AIoT-Consulting/atr-public/3d/ATR-USB-3D Case Cover Label.pdf

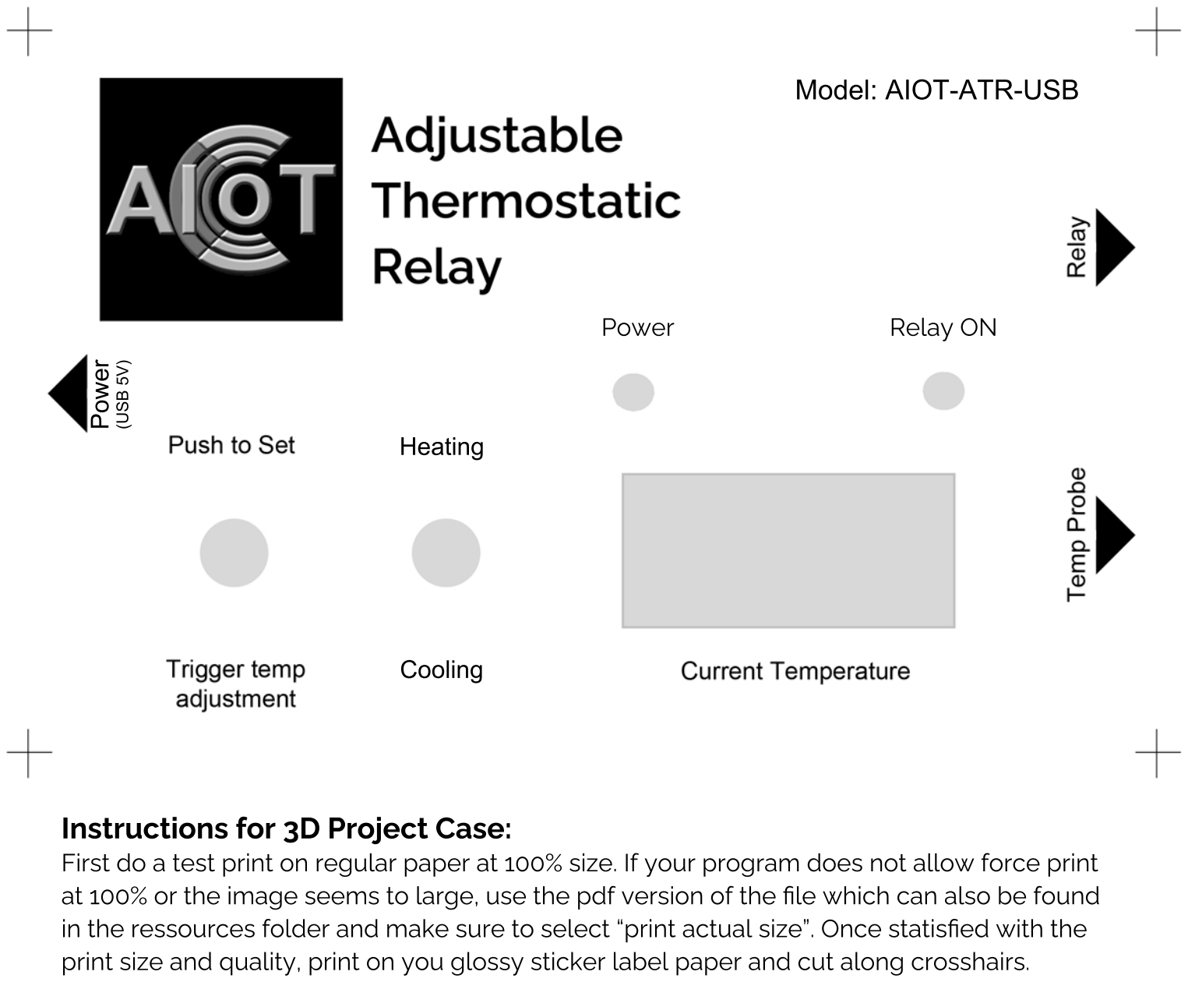
[picture p1: page 1]

### Instructionsfor3DProjectCase:

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

Heating

Cooling

Power (USB5V)

Model:AIOT-ATR-USB

Power | RelayON
