AIoT-Consulting/atr-public/Fielect/ATR-USB-Fielect Case Cover Label.pdf

# Adjustable Thermostatic

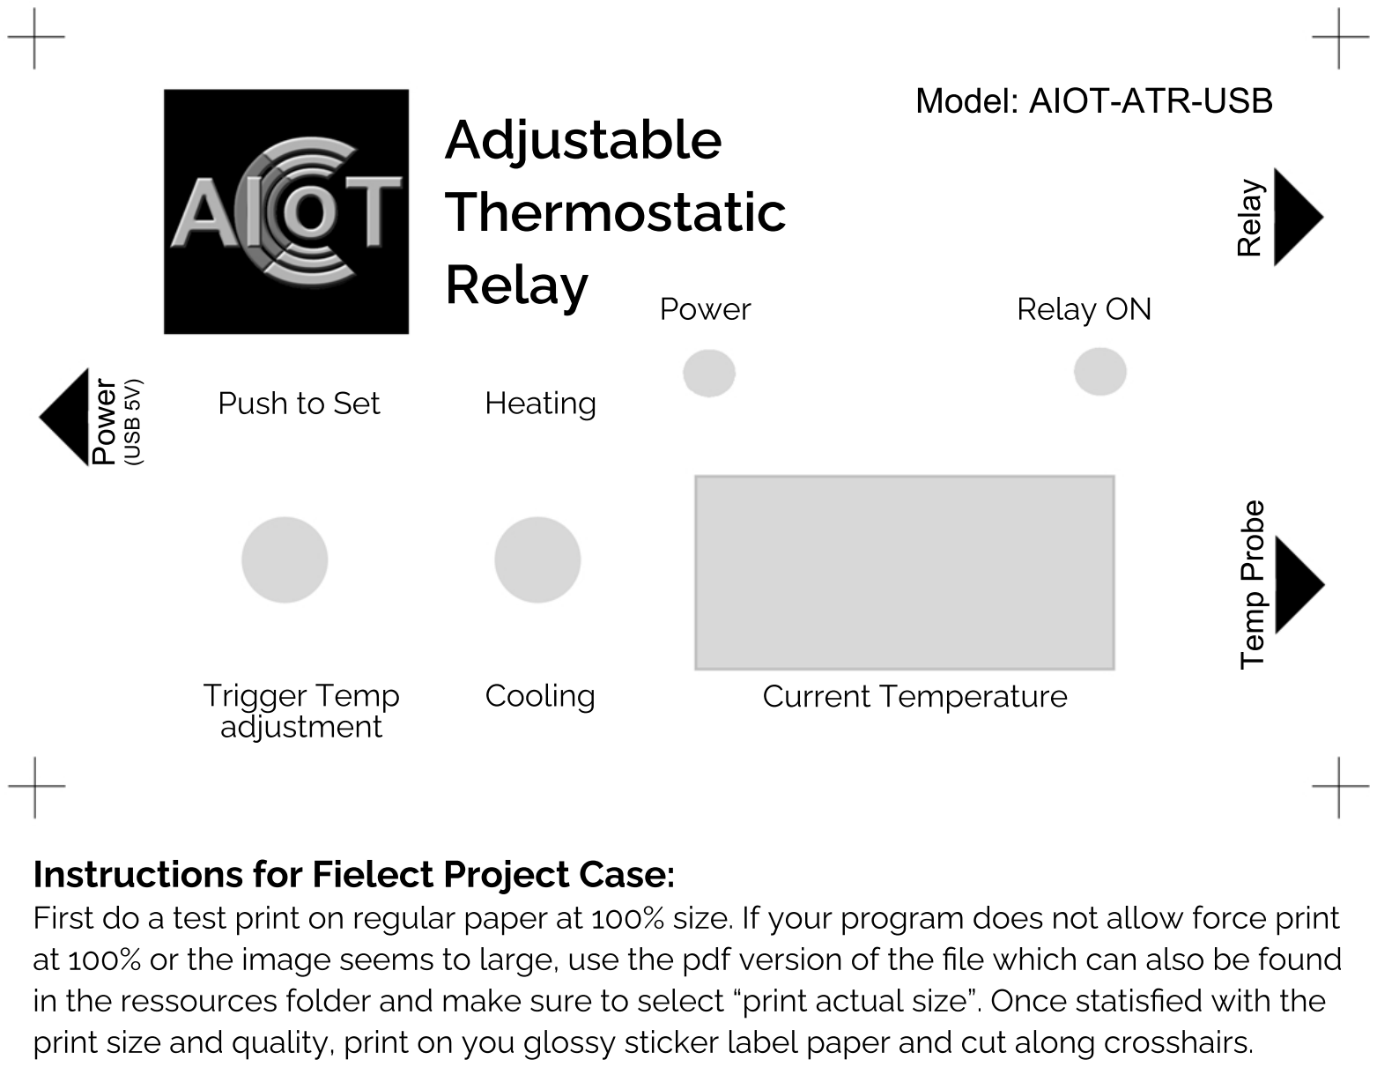
[picture p2: page 1]

# Relay

Model:AIOT-ATR-USB

TempProbe Relay

Power (USB5V)

Power | RelayON
Cooling | CurrentTemperature
PushtoSet | Heating

### InstructionsforFielectProjectCase:

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

TriggerTemp adjustment
