AIoT-Consulting/atr-public/3d/ATR-USB-3D Case Cover Label.png

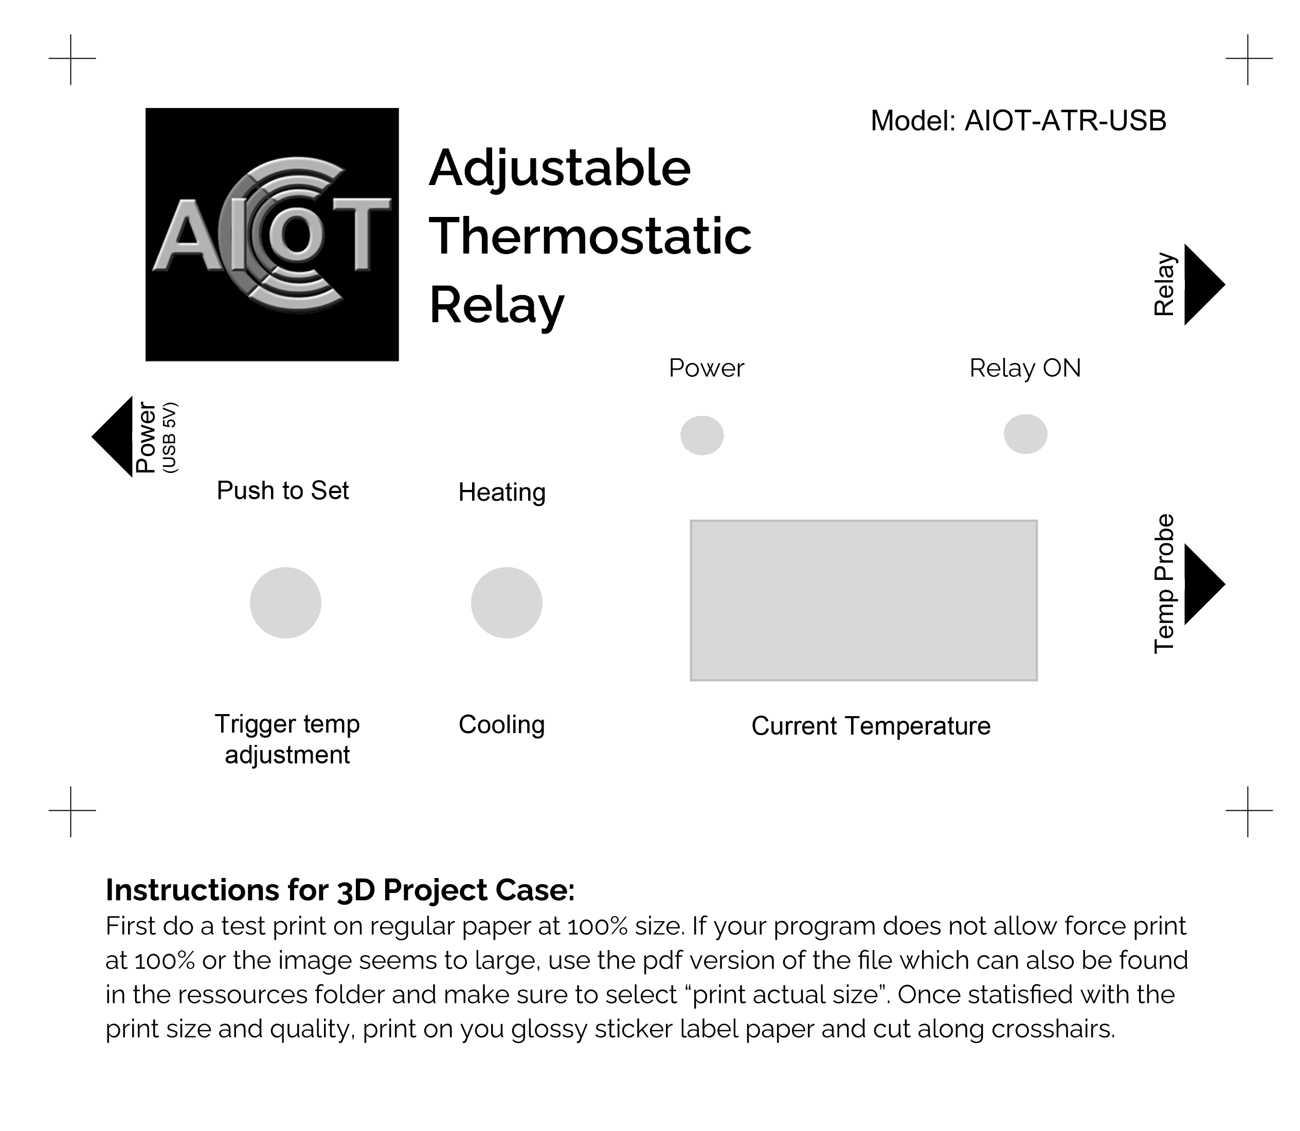
3d/ATR-USB-3D Case Cover Label.png
