AIoT-Consulting/atr-public/Fielect/ATR-USB-Fielect Case Cover Label.png

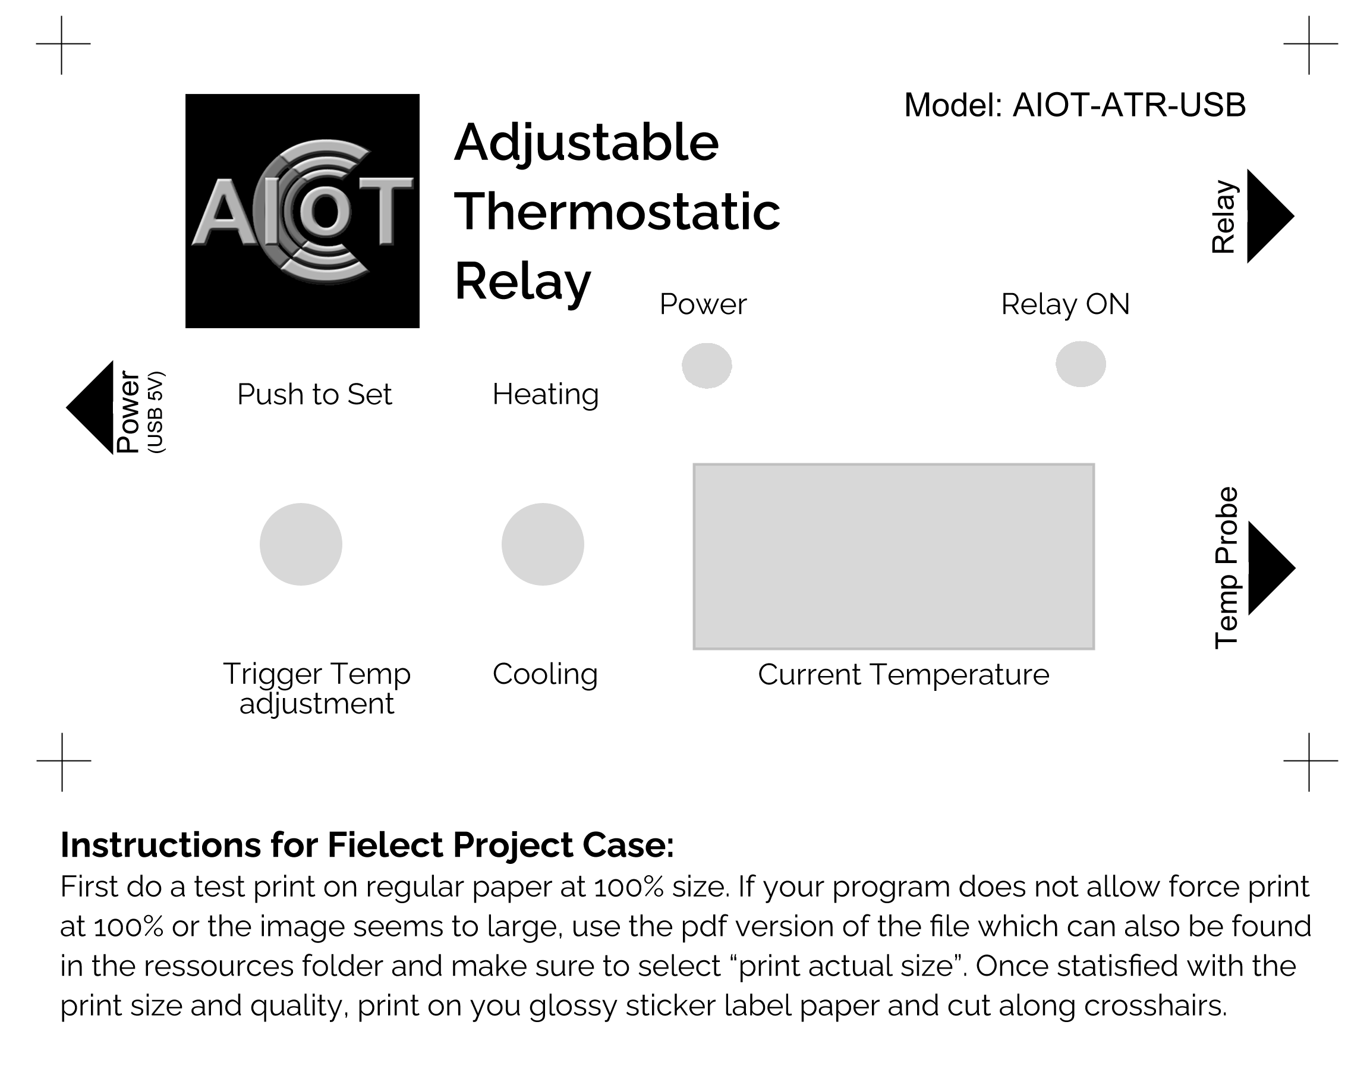
Fielect/ATR-USB-Fielect Case Cover Label.png
