AIoT-Consulting/atr-public/Fielect/ATR-USB-Fielect Drill Template.png

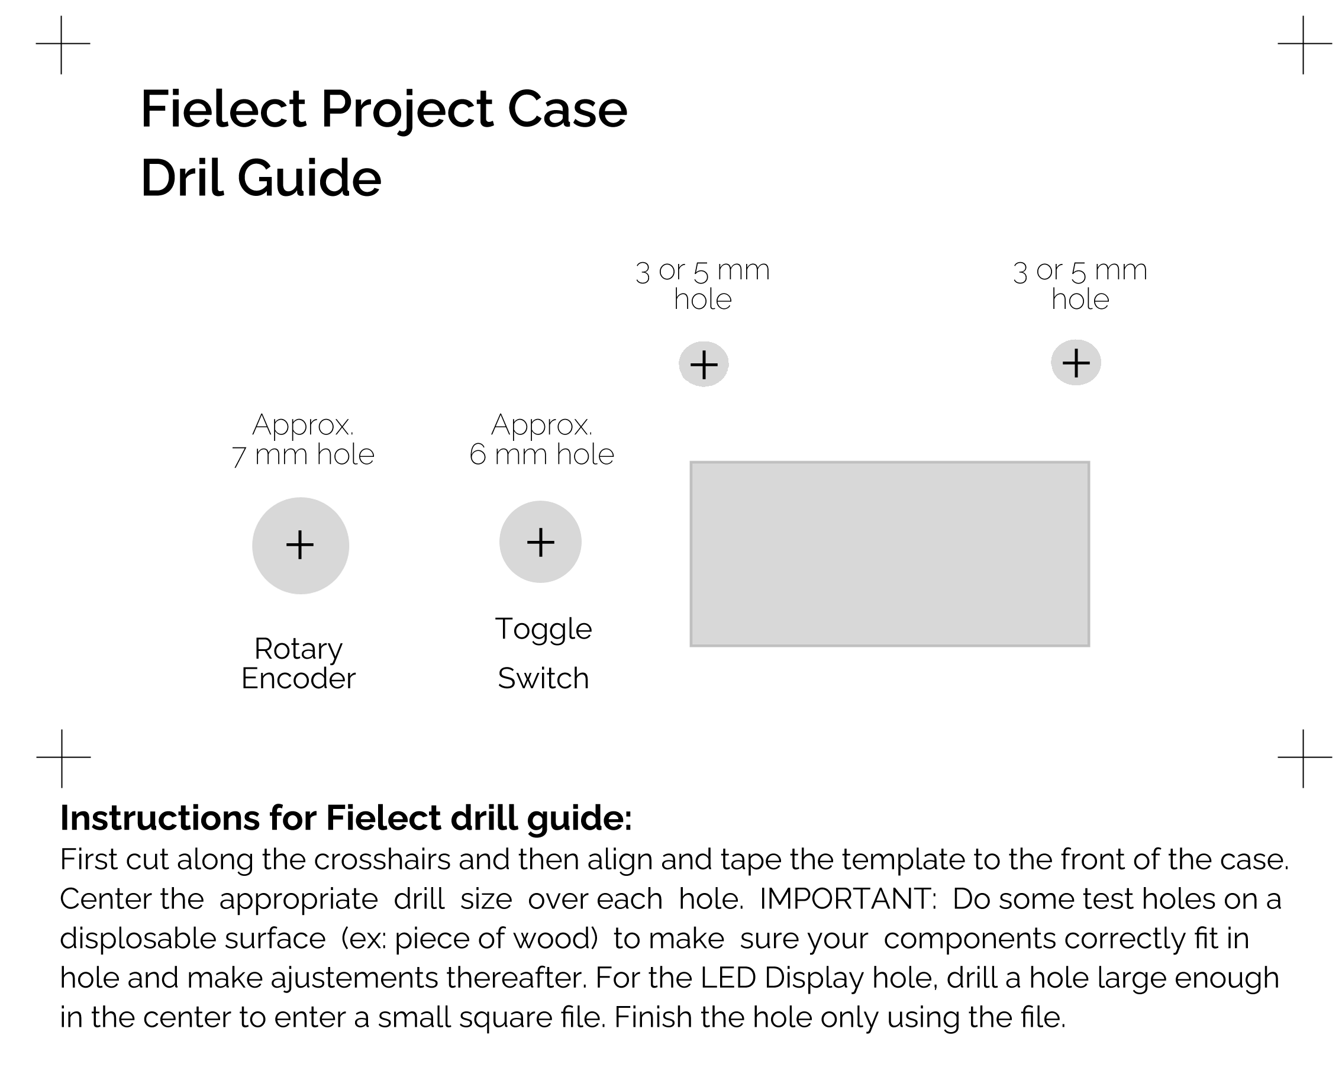
Fielect/ATR-USB-Fielect Drill Template.png
