AIoT-Consulting/atr-public/3d/ATR-USB_Case.stl

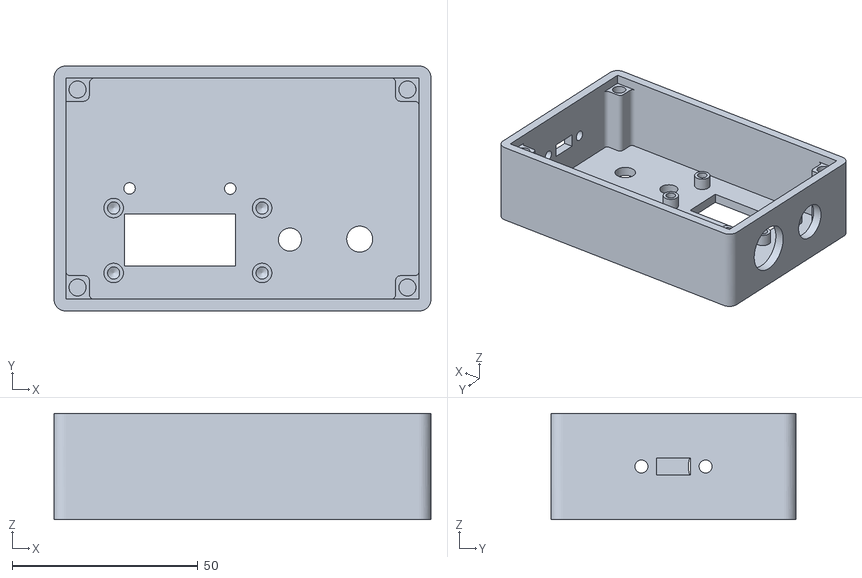
[picture p6: CAD file, 2025-04-01]
3d/ATR-USB_Case.stl
101.6 x 66.0 x 28.6
