AIoT-Consulting/atr-public/3d/ATR-USB-Cover.stl

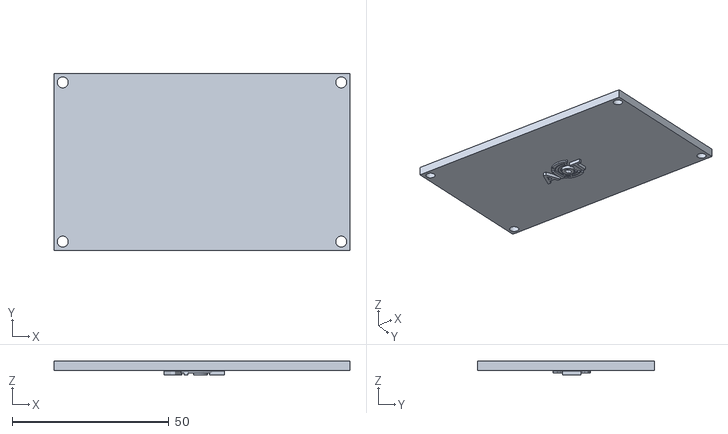
[picture p7: CAD file, 2025-04-01]
3d/ATR-USB-Cover.stl
94.5 x 56.4 x 4.61
