AIoT-Consulting/atr-public/ATR Portable Project Guide.pdf

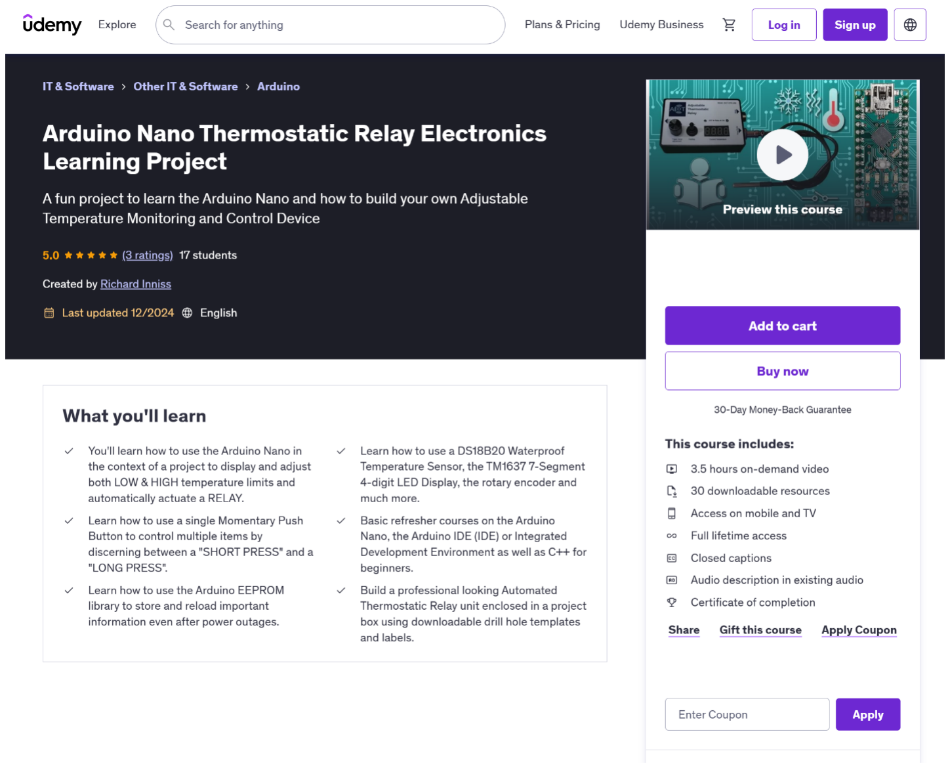
[picture p54: figure]
